JustinPeng2007/ISEF2022/README.md

# SF2022
#### Taking Control: A Novel Galvanic Stimulation Device for the Visually Impaired 
  githubfrontpage

## Table of Contents
* [Introduction](#introduction)
* [Technologies Used](#technologies-used)
* [Setup](#setup)
* [Acknowledgements](#acknowledgements)
* [Contact](#contact)
<!-- * [License](#license) -->

## Introduction
   It's a futuristic concept - being able to fully control and steer a person out of the trajectory of incoming objects and hazards. Although this seems impossible, utilizing a non-evasive procedure named the Galvanic Vestibular Stimulation (GVS), was done safely and with few side effects. Using a special stereo sensor and an object detection algorithm, incoming objects within a 3-meter range are recognized. A python algorithm then determines the best trajectory to avoid the object through UDP packets to another device. The GVS device receives the packets and steers the subject autonomously according to the packets received.

## Technologies Used
  #### Hardware
  ```
  -	1 Intel RealSense Depth Camera D435
  -	1 Chest mount harness
  -	1 Tripod mount
  -	1 Tripod mount to ¼” screw conversion adapter
  -	1 5ft+ USB-A (v3.0+) to USB-C
  -	1 Laptop (CUDA-Enabled)
  -	1 Backpack
  ```
  #### GVS System
  ```
  -	1 Custom Designed PCB
  -	1 ESP8266 WIFI MCU
  -	1 MT3608 Boost Regulator
  -	2 1/4W 1.8k Ohm 5% Resistors
  -	2 1/4W 12k Ohm 5% Resistors
  -	1 1/4W 220 Ohm 5% Resistors
  -	7 1/4W 5.6k Ohm 5% Resistors
  -	4 2N3904 Transistors
  -	4 2N3906 Transistors
  -	1 Conn_01x03_Male Pin Header
  -	1 Conn_01x04_Male Pin Header
  -	1 Conn_02x04_Female Pin Header
  -	4 Conn_01x01_Male Pin Header
  -	1 3.5mm stereo jack (female) to 3P terminal
  -	1 Battery holder 2xAA with on/off switch
  -	4 M2x14mm screws
  -	4 M2x6mm female to female standoffs
  -	4 M2 Hex Nuts
  -	6 Female to female jumper wires
  -	1 Unshielded jumper wire
  -	1 USB ESP8266 Breakout
  -	1 3.5mm Electrode pad wire
  -	2 5x5cm Electrode pad
  ```
  #### Software
  ```
  -	Arduino IDE development platform
  -	Python 3.6.0
  ```
  #### 3D printed
  ```
  -	Housing Case
  -	Housing Lid
  ```

## Setup

Please refer to the "Setup Guide" folder for further instructions.

## Acknowledgements

  I would like to express my deep gratitude to my mentor, Mert Kaval, for his feedback and guidance throughout the project. I would also like to thank Ms. Leong, for helping me proofread most of the parts related to science fair. Finally, I wish to thank my parents for their support and encouragement throughout my studies.

## Contact
Contact Justin Peng by email: justinpeng5@gmail.com

## License
This project is open source and available under the GNU General Public License v3.0. Refer to [LICENSE.md](LICENSE) file for more details.
