JustinPeng2007/ISEF2022/Python Algorithm/Code Breakdown.pdf

# Taking Control: A Novel Galvanic Stimulation Device for the Visually Impaired

### Justin Peng

### Python Algorithm Breakdown/Explanation

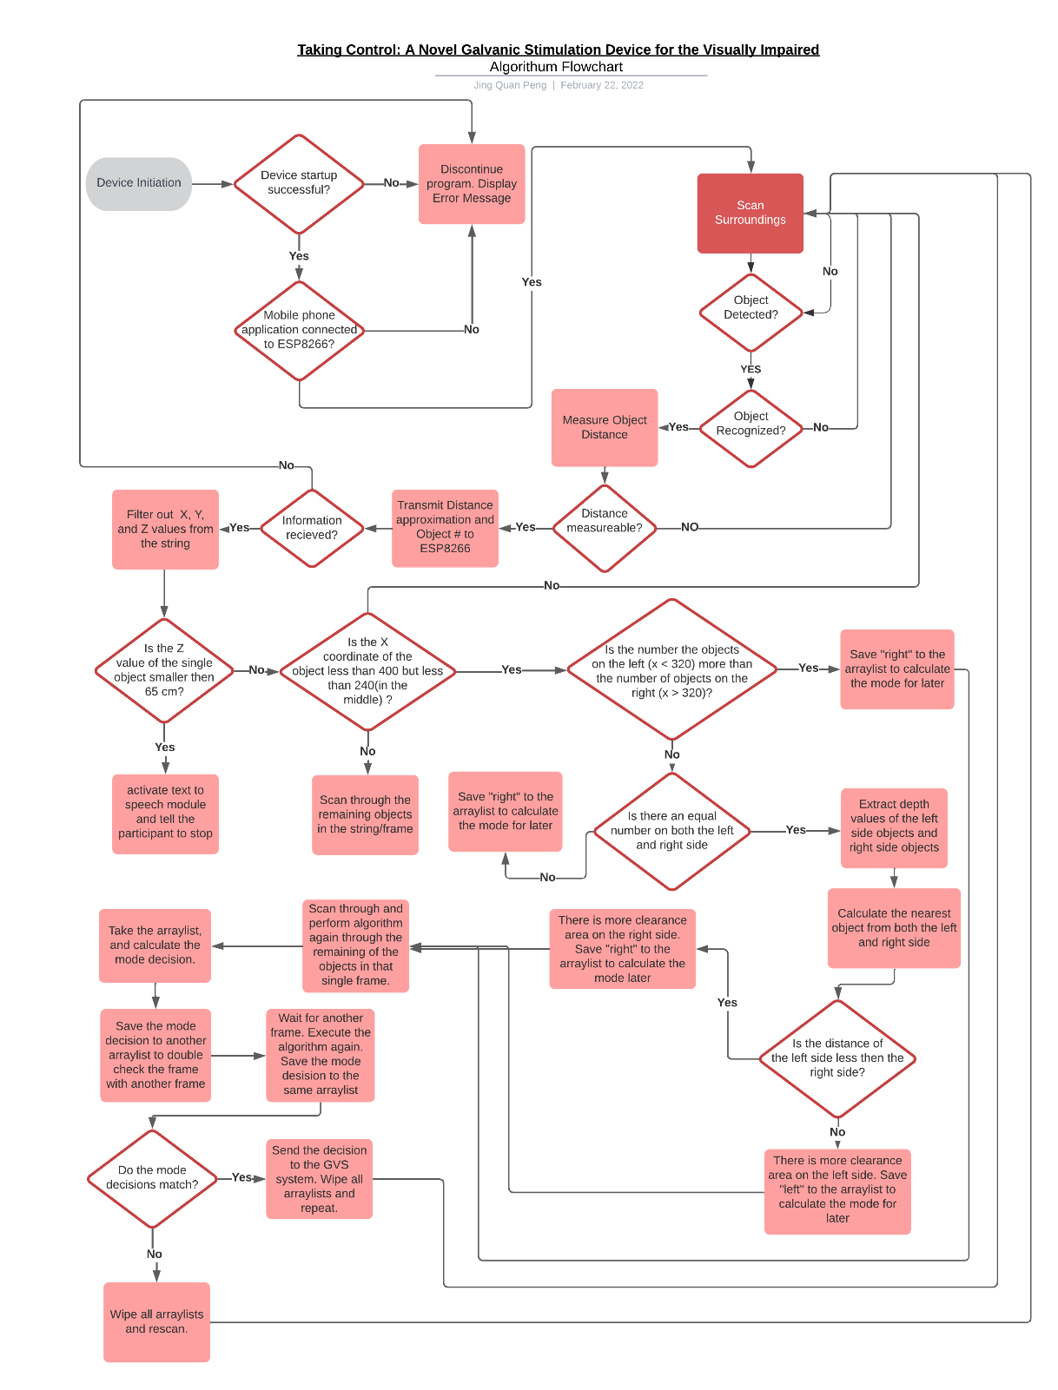
[picture p3: figure]
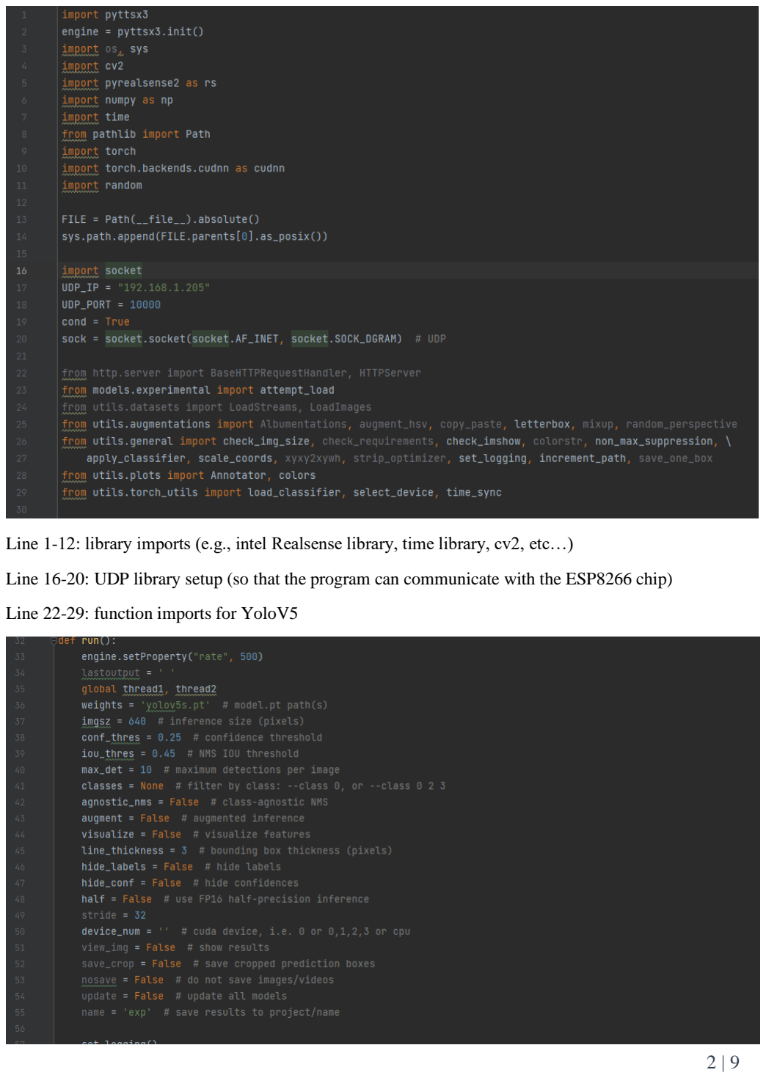
[picture p4: page 2]

Line 1-12: library imports (e.g., intel Realsense library, time library, cv2, etc…)

Line 16-20: UDP library setup (so that the program can communicate with the ESP8266 chip)

Line 22-29: function imports for YoloV5

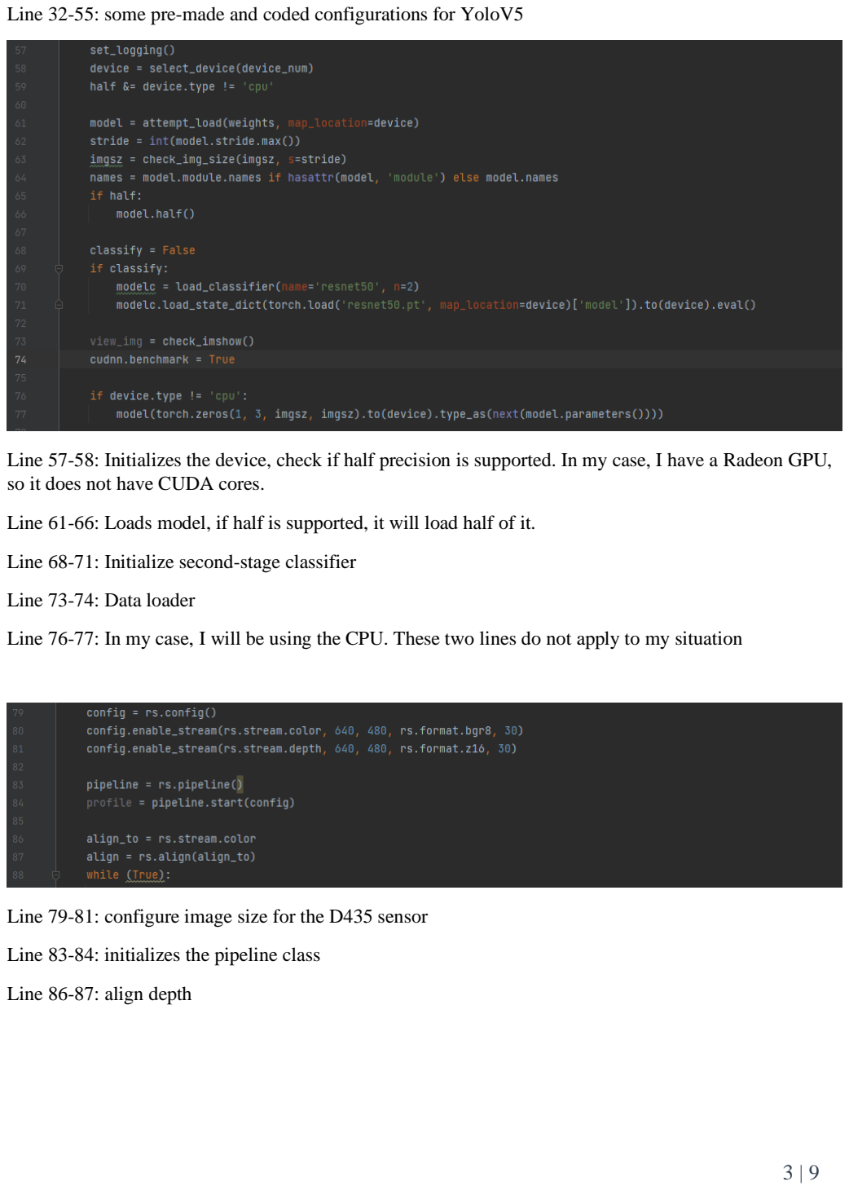
[picture p5: page 3]

Line 32-55: some pre-made and coded configurations for YoloV5

Line 57-58: Initializes the device, check if half precision is supported. In my case, I have a Radeon GPU, so it does not have CUDA cores.

Line 61-66: Loads model, if half is supported, it will load half of it.

Line 68-71: Initialize second-stage classifier

Line 73-74: Data loader

Line 76-77: In my case, I will be using the CPU. These two lines do not apply to my situation

Line 79-81: configure image size for the D435 sensor

Line 83-84: initializes the pipeline class

Line 86-87: align depth

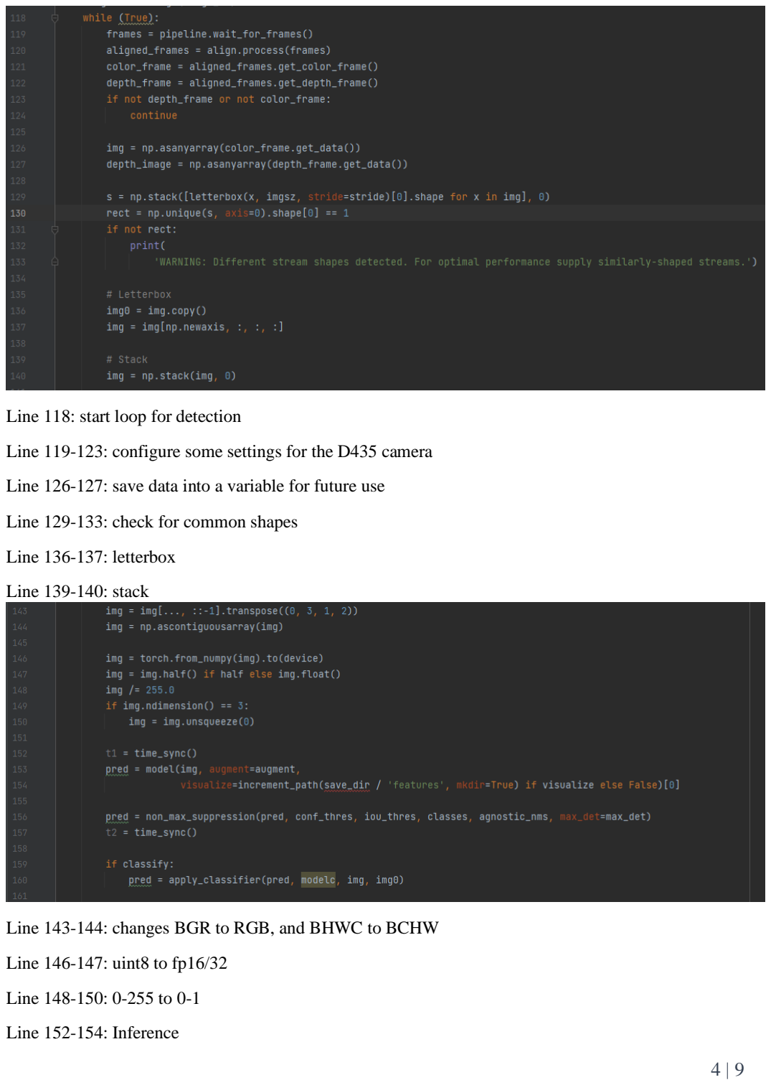
[picture p6: page 4]

Line 118: start loop for detection

Line 119-123: configure some settings for the D435 camera

Line 126-127: save data into a variable for future use

Line 129-133: check for common shapes

Line 136-137: letterbox

Line 139-140: stack

Line 143-144: changes BGR to RGB, and BHWC to BCHW

Line 146-147: uint8 to fp16/32

Line 148-150: 0-255 to 0-1

Line 152-154: Inference

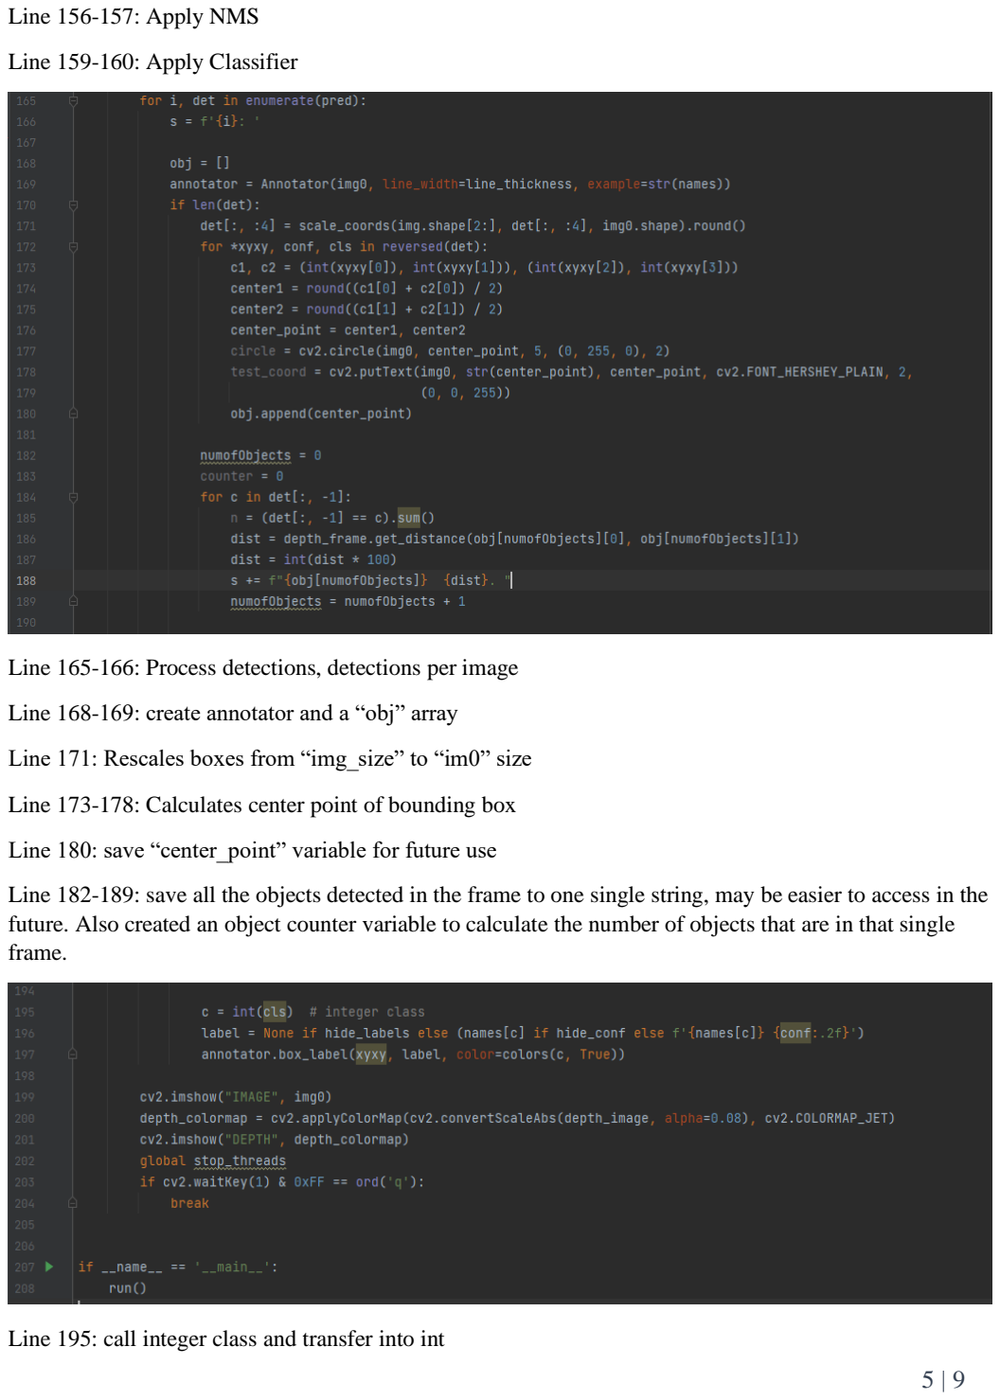
[picture p7: page 5]

Line 156-157: Apply NMS

Line 159-160: Apply Classifier

Line 165-166: Process detections, detections per image

Line 168-169: create annotator and a “obj” array

Line 171: Rescales boxes from “img_size” to “im0” size

Line 173-178: Calculates center point of bounding box

Line 180: save “center_point” variable for future use

Line 182-189: save all the objects detected in the frame to one single string, may be easier to access in the future. Also created an object counter variable to calculate the number of objects that are in that single frame.

Line 195: call integer class and transfer into int

Line 196-197: label the bounding box with the object names

Line 199-201: show image and depth map on screen for the user to see

Line 202-203: if the user presses the “q” key, the program will stop

Line 207-208: run the program

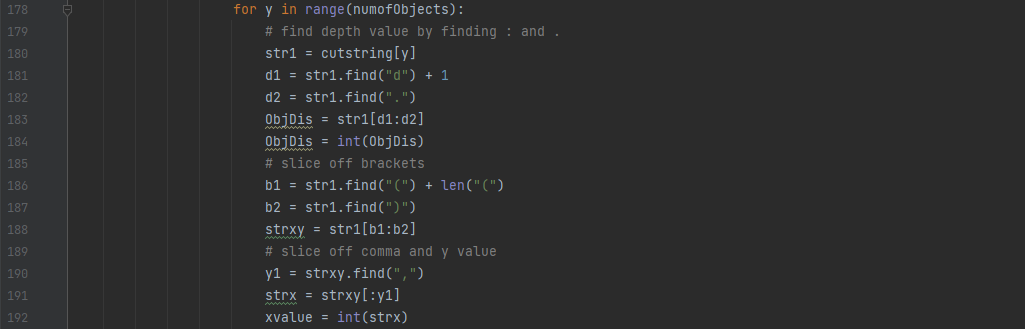
[picture p8: figure]

Line 180-184: Filters out the depth value by finding the “:” and “.” to substring it. It then converts it to an integer so it can be used to compare with other values in the future

Line 186-192: Finds brackets “(“and “)” and then “,” to substring it to find the x value. It is then turned into a integer variable.

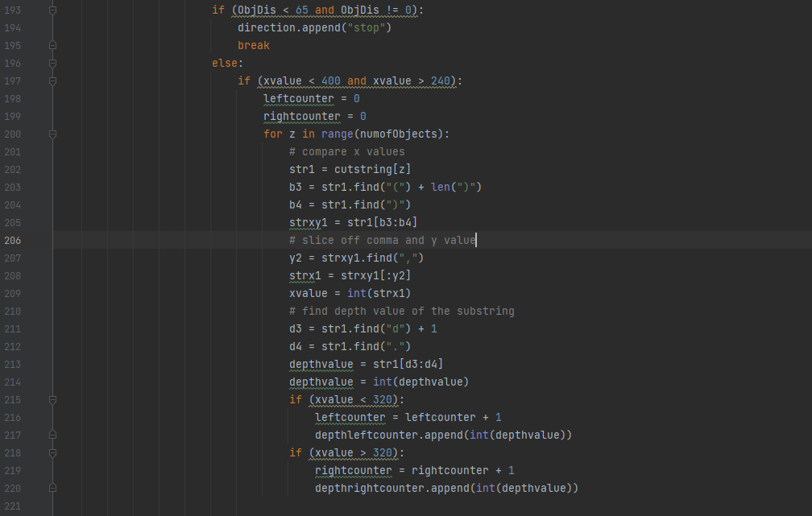
[picture p9: figure]

Line 193-195: If the object distance is less then 65 meters away, or does not equal to zero, it saves “stop” to the first array list called “direction”

Line 196-220: Similar to line 180-192, it filters everything else except the x value. As seen on the for loop on line 200, it goes through every single one of the objects in the frame and records them down. If the object it is calculating right now in this frame is on the left side (x < 320), it will add one to the left counter and one to an array list (reason is explained later). If the object it is calculating right now in this frame is on the right side (x > 320), it will add one to the right counter, and add the value to an array list.

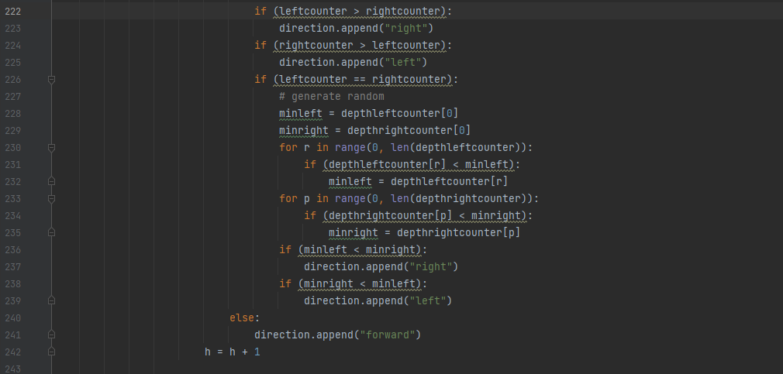
[picture p10: figure]

Line 222-223: If the left counter is greater then the right counter “right” will be added to an array list called “direction. This is because if there are more objects on the left side, it would be reasonable to go to the opposite direction where there are less objects. If the right counter is greater then the left counter, “left” will be added to the same array list.

Line 226-239: This is where the array list “depthleftcounter” and “depthrightcounter” comes in. If there is an equal number of objects on both the left and right side, it will perform the following. From depthleftcounter, it will find the nearest object on the left. From depthrightcounter, it will find the nearest object on the right. If the object on the left, is nearer then the object on the right, “right” will be added to yet another array list (to double check in the future) because there is more space on the right. If it is the opposite, then it is on the right.

Line 241: This “else” is attached to the previous “if” statement where it calculates whether there is any objects in the middle. If the object is outside the range, it will add “forward” to the array list.

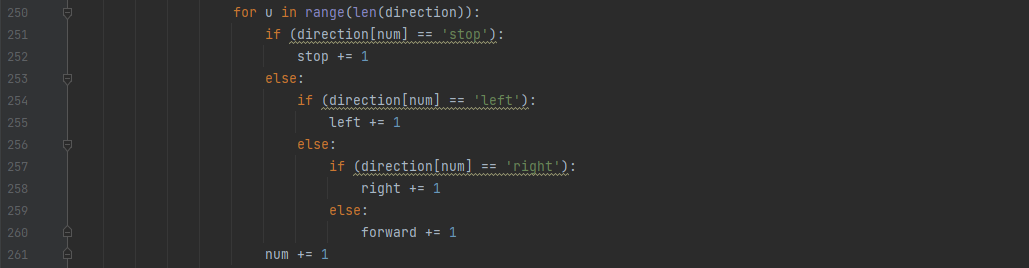
[picture p11: figure]
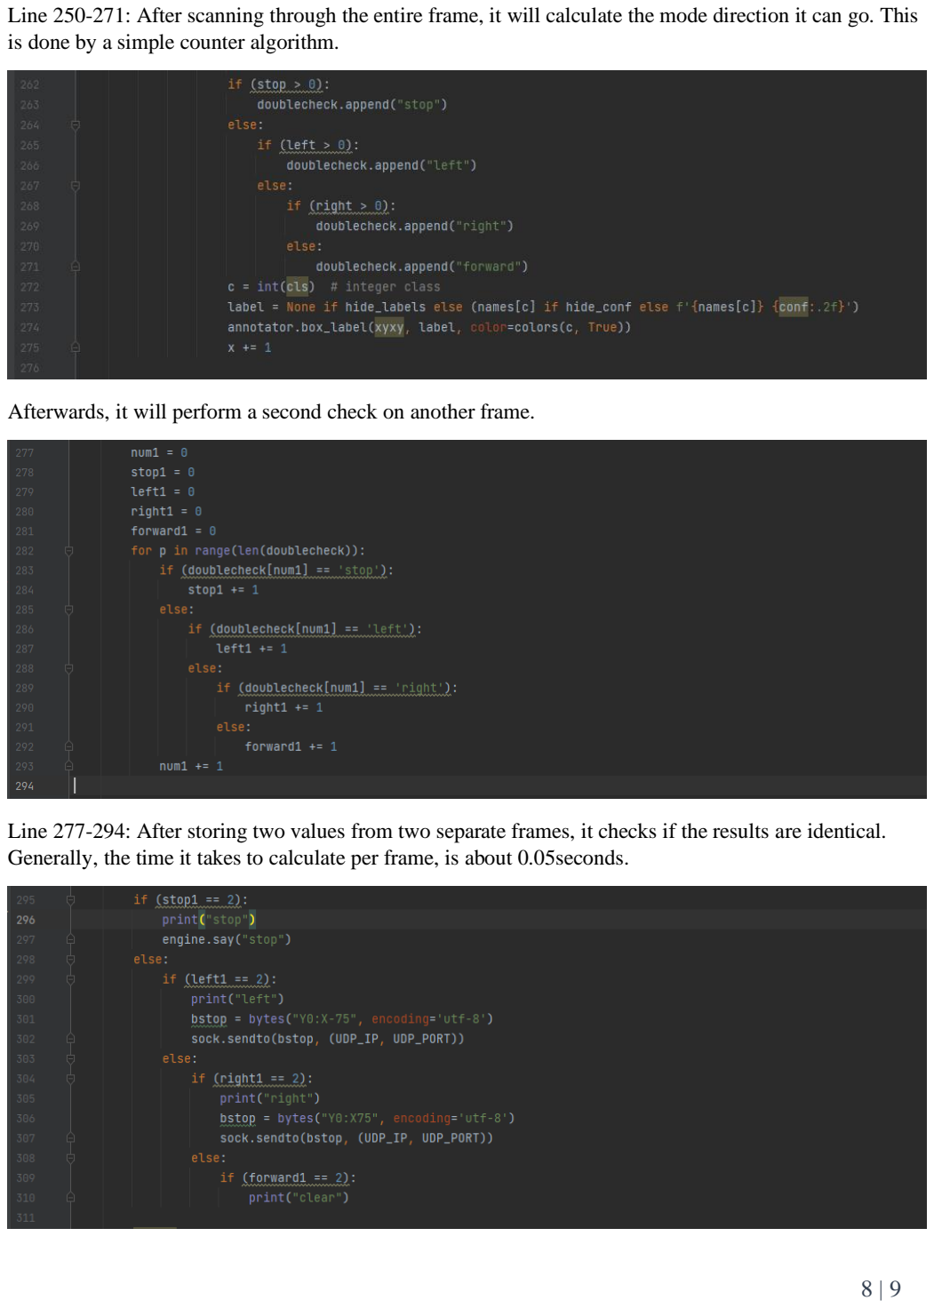
[picture p12: page 8]

Line 250-271: After scanning through the entire frame, it will calculate the mode direction it can go. This is done by a simple counter algorithm.

Afterwards, it will perform a second check on another frame.

Line 277-294: After storing two values from two separate frames, it checks if the results are identical. Generally, the time it takes to calculate per frame, is about 0.05seconds.

Line 295-310: If the two results match (counter is equal to two), it will finally send the result through the packets module to the ESP8266.
